Pomax/arduino-midi-recorder/(threads)

Thread 1 (2020-12-24):

pitch bend seems to be encoding the wrong values

Pomax, 2020-12-24:
instead of going from center to top and center to bottom, pitch bending up seems to go from 0 to center, and pitch bending down seems to go from max to center...

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

Pomax, 2020-12-24:
Need to add 0x2000 to the pitch bend value in order to center it correctly.

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

Pomax, 2020-12-24:
fixed

Closed 2020-12-24.

Thread 8 (2021-03-24):

[SOLVED] recorded MIDI files are not useable or corrupt

othmar52, 2021-03-24:
@Pomax thank you for this great project and the detailed documentation!!!
Currently i am trying to build my own recorder with an Arduino UNO R3 and a [TFT/SD shield](https://create.arduino.cc/projecthub/javagoza/2-4-tft-lcd-touch-display-road-test-89f51b) based on your sketch.

Due to the huge amount of PINS used by the shield i have no button for creating markers or any kind of audio debug.
Currently i do not use a RTC as well but i am going to implement this as soon as everything works.

my TFT shows an incoming-note-indicator, incoming cc-indicator, the current filename of the recording and the recording time.
so everything works as expected except one thing:

The created MIDI files seems to be corrupt or not readable.
I tried different kinds of midi file supporting software. One of those is [upload form of onlinesequencer.net](https://onlinesequencer.net/import).

The error message of the "vanilla version" reads:
```
Could not parse MIDI file: Track data exceeds expected length (1/0)
```
After fixing the track_length bytes with `fix.py` i get a different error:
```
Could not parse MIDI file: Track data exceeds expected length (59/56)
```
I also tried to manipulate the calculation of track_length in `fix.py` to avoid the error above but then i get:
```
Unexpected EOF
```

As `.mid`files are not attachable i have created a `.zip` with short recordings of 3 noteOn + noteOff events.
[test-recordings-vanilla-and-fixed.zip](https://github.com/Pomax/arduino-midi-recorder/files/6195740/test-recordings-vanilla-and-fixed.zip)
```
FILE-061-vanilla.MID
FILE-061-fixed_length.MID
```

I used `FAT16` filesystem for the SD.
Obviously there are some bytes in the recordings that shouldn't be there, right?
Do you have any hint how to fix this?

othmar52, 2021-03-24:
i solved it myself:
after formatting the SD card with `FAT32` instead of `FAT16` everything worked

Pomax, 2021-03-25:
Yeah, never use FAT16.

Closed 2021-03-24.

Thread 9 (2021-03-24):

[QUESTION] how to add license in fork?

othmar52, 2021-03-24:
@Pomax As you might have noticed i have created a [fork with a lot of changes](https://github.com/othmar52/arduino-midi-recorder) based on your repository.
I kept your license notice in the main sketch file.
Please tell me if this enough or if a have to do more in terms of license.
I don't want to violate any license agreements!

Pomax, 2021-03-25:
https://github.com/Pomax/arduino-midi-recorder/blob/master/midi-recorder.ino#L379-L388

If you live in a jurisdiction that does not recognize the public domain (France etc), then the code is MIT licensed and you can act in accordance to that - if you live anywhere else, my code is public domain code meaning you're literally free to do whatever you like with it =)

Pomax, 2021-03-25:
That said, I'm not sure how your code works, given that the .mid file hex setup and `writeToFile` function seem to be missing?

othmar52, 2021-03-25:
> meaning you're literally free to do whatever you like with it =)

Thank you for clarification!

> ... it looks like you removed the the .mid file hex setup, as well as the writeToFile function?

No, i only removed the createMarker and the debugAudio stuff. i prefer to have multiple `.ino`'s for better maintainability.
Pretty sure you already know that all existing `.ino`'s gets concatenated during compiling within most ide's!? Case not, maybe you will try it yourself on your next huge sketch.

> ...Now you need a computer...

No, i don't use a computer in my synth setup. but a few standalone midi interfaces with lots of routing options (iConnectivity 1x `mioXL` + 2x `ICM4+`). But you are right, theroretically it is possible to have it inline in my routing but it does not make any sense.
Maybe i'll add a DIN midi in+out too. In my testing of other arduino+midi projects i noticed that USB- and DIN-midi works both without changing anything in the sketch

> ...at the very least, mac and windows...

I dont have those OS. But in general it does not make sense to send midi to an arduino for recording. In such a scenario i would prefer to record the midi directly on the pc.

Pomax, 2021-03-25:
>No, i only removed the createMarker and the debugAudio stuff

I searched your code for writeToFile and don't see it in any of the ino files though?

othmar52, 2021-03-25:
> I searched your code for writeToFile and don't see it in any of the ino files though?

stille there: [20-sd-rtc.ino#L143](https://github.com/othmar52/arduino-midi-recorder/blob/c363afa340de0b1840fa705fc41532facdc41b6e/20-sd-rtc.ino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)

Pomax, 2021-03-25:
oh, interesting that github didn't find it when I used their code search. Then again, their code search has never been all that good...

Closed 2021-08-12.

Thread 10 (2021-08-12):

Add audio?

hendog518, 2021-08-12:
Have you considered a version of this project that also records audio?

I don’t know the first thing about this stuff (if I make this, it’d be my first arduino project) and how much complexity that would add, but for synths and drum machines and other MIDI toys that one might like to use without a pc, I think a parallel recording of the actual audio (and a similar “audio in / audio thru” setup) would add very handy functionality.

Pomax, 2021-08-12:
Given that there are a million fantastic inline audio recorders available at almost every price point: nope. No point, for the cost of an arduino and circuitry, you can get a better assembled, price-appropriate quality consumer device that comes with a manufacturer and shop warranty =)

Closed 2021-08-12.

Thread 11 (2022-07-07):

Playback  & SysEx?

Klokdoc, 2022-07-07:
First of all, what a good idea.  I'm still using a 3 1/2" disc recorder/player which is becoming unreliable.
I'd like to build a similar device that would also play back.   I'd have to record all the SysEx codes as well, my instrument relies on them.  It's a three manual electronic organ with pedals so has four channels, all on one track, and stops, swell pedals, etc are all done by SysEx codes (0F?).  MIDI files produced by this instrument will only work on this instrument, it's a custom design.
Is this feasible?
Thanks,
Chris

ColbyDAllen, 2023-09-20:
How hard would it be to implement a looper with Play/Record functionality that updates an existing SMF format 0 .mid file during playback?

Say you're trying to recorder a drum pattern for instance, so only one channel is needed, and you're just playing a different pitch assigned to a different percussion instrument. Could you write a second line over your first pattern on the same channel, different pitch? Like an audio overdub, but a midi-overdub? Like this:

|| "I'm MIDI file (A)...                                   ...and together we are..." ||
||                          "And I'm MIDI file (B)... ...and together we are..." ||

ONE .MID FILE!!! Lol.

Or maybe simultaneous play record would only be possible if the file being recorded to was not the same one being played?

Just trying to wrap my head around feasibility, whether I'd need a second storage device for playback, or if a fresh overhaul would make more sense.

Best,
Colby

Pomax, 2023-09-20:
That sounds like a MIDI looper, of which there are many already =)

ColbyDAllen, 2023-09-20:
Beautiful! I've tried nearly every other combination of keywords, especially "sequencer" -related projects, but I see you're not kidding. Will be looking into this tomorrow. Thank you.

ColbyDAllen, 2023-10-24:
I was mulling this over this morning, not necesarily SysEx events, but have calls/callbacks outside of the <MIDI.h> looping Note-On events:

Do you think it's possible to have multiple calls to the "void writeToFile(byteType, byte b1, byte b2, int delta)" function?

```
/*
    For instance have the original:
*/
void handleNoteOn(byte channel, byte pitch, byte velocity) {
  writeToFile(NOTE_ON_EVENT, pitch, velocity);
}

/*
    AND have separate function:
*/
void ThisNoteLOOPED(byte channel, byte pitch, byte velocity) {
  writeToFile(NOTE_ON_EVENT, pitch, velocity);
}
```
...working simultaneously...

```
/*
    ...both being fed into the function:
*/
void writeToFile(byte eventType, byte b1, byte b2, int delta) {
  if (!file) return;
  writeVarLen(file, delta);
  file.write(eventType);
  file.write(b1);
  file.write(b2);
}
```

...without breaking how the bytes are being fed to the SD card?

ColbyDAllen, 2023-10-24:
There's a much larger sketch I'm using to toy with this idea, but the above is the distilled concept. Obviously you'd want a corresponding "void ThisNoteOffLOOPED" function for the additional stream of notes...

Happy to share the full sketch if you'd be interested.

Best,
Colby

Pomax, 2023-10-25:
no, what you wrote as "simultaneous" code will write completely different bytes.

(note that I'm closing this issue mostly because we drifted well away from the original issue at this point)

ColbyDAllen, 2023-11-01:
Sorry about that, and got you. Thanks for clarifying!

Pomax, 2023-11-01:
feel free to open a new issue though!

Closed 2023-10-25.

Thread 12 (2023-09-12):

Analog Pins As MIDI-IN?

ColbyDAllen, 2023-09-12:
Hi there!

I built out your project step by step yesterday, and it works great!

However, I'm trying to build a standalone sequencer, equipped with 4 FSR sensors as inputs, outputting midi data over a single midi channel(0). While the 5-PIN DIN works great with your sketch, I'm having trouble with code to replace the input on RX pin 0 with the input from my four analog sensor pins.

I tried replacing all the MIDI.h-related functions/defines/etc. with their usbMIDI.h equivalents (Plus my original sketch for simply reading/ writing the analog signals to 7-bit MIDI messages). Have you tried analog sensors with this project?

Serious thanks for posting your process here, the humor was refreshing, and I'm sure that it has been time consuming.

Best,
Colby ☮️

Pomax, 2023-09-13:
Hmm, can't say I have, but there is the bank of analog pins (A0 through A5) that aren't dedicated RX/TX that you might be able to use for that purpose, too? I used A4 and A5 for the real time clock, but that leaves exactly 4 for individual analog signals =)

ColbyDAllen, 2023-09-13:
Hi Pomax,

Thanks so much for the quick response. Actually I got your sketch to work on a teensy 4.1 with Rev D2 audio shield - but I think after some more reading last night, my problem likely has to do with the file the file management, going from MIDI-->.mid.

Between reading Standard midi specs & what was mentioned here - https://forum.pjrc.com/threads/31797-Teensy-FSR-based-MIDI-controller regarding <usbmidi.h> and <midi h>, it sounds like there may be some inconsistencies between the way the <midi.h> and <usbmidi.h> libraries arrange their information when handing off the bits and bytes to the microSD card.

Probably too much information. Just thought I'd share my experience and (hopeful) implementation of what you've done here.

Everything you shared in your article/project works great so far, thanks again!

Pomax, 2023-09-13:
At least the MIDI spec is stupidly simple, so if you're not afraid of "getting your toes wet" you can have a look at the code in the .ino file that deals with just writing bytes to a file without bothering with any predefined .h file (other than the sd card headers of course =)

ColbyDAllen, 2023-09-18:
Got it working! Thanks ma friend! I took your advice on taking a plunge, or at least dipped a toenail in! Mostly C++ practices (structs, classes, pointers, dereferencing, Namespaces, identifiers, etc...), and routed my analog pins variable[s] through an intermediary function which allowed for the parameters to be rearranged to fit neatly into their respective Status- and data-bytes.

Although I relied on library shortcuts, I'm definitely feeling inspired to study up more on SMF format specifications, 8-to-7-bit bit-shfiting, and the SysEx side of MIDI to reduce reliance on libraries in the future.

Pardon my random jabber.  In case anyone's curious or facing similar challenges, here is the function in Pomax's sketch that required special attention in order to substitute the original 5-pin DIN input with FSR sensors wired to analog pins:

// ======================================================================================
/**
          // delta     eventType       b1        b2
        <delta> <event code> <byte> <byte>
*/
void writeToFile(byte eventType, byte b1, byte b2, int delta) {
  if (!file) return;
  writeVarLen(file, delta);
  file.write(eventType);
  file.write(b1);
  file.write(b2);
}

// ======================================================================================

Phew + Vwalha!! Works as intended so far.

Best,
Colby

Pomax, 2023-09-18:
Nice! (but note that your function comment didn't have the right order for the actual function parameters =D)

ColbyDAllen, 2023-09-18:
My bad😅

Awesome article - hard to overstate. A little C++ fluency has opened my eyes to few open-source projects that incorporate micro-controller-to-SD-Card reading/writing that would’ve been utter Greek to me a week ago.

If you don’t mind me asking, on line 49 of your .ino — What is the purpose of the “HAS_MORE_BYTES 0x80” (note-off, channel 1) global definition? I see it’s used later in the "void writeVarLen(File file, unsigned long value){...}" function provided by the MIDI file format specification, but why the use of a NoteOff message for file writing?

Pomax, 2023-09-20:
it's not "note off, channel 1", it's the bit mask 0x01000000, used to set the the 7th bit to `1` as per the spec requirement for variable length quantities.

> Some numbers in MIDI Files are represented in a form called VARIABLE-LENGTH QUANTITY. These numbers are represented 7 bits per byte, most significant bits first. All bytes except the last have bit 7 set, and the last byte has bit 7 clear. If the number is between 0 and 127, it is thus represented exactly as one byte.

ColbyDAllen, 2023-10-18:
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

Ohh! Got you now. Variable Length Quantity is a bigger deal then I'd realized going into this project. It's starting to make more sense after reading into "bit-masking".  Thank you for the detailed explanation.

Thread 13 (2023-09-15):

SD card lifetime

dazarz, 2023-09-15:
I'm wondering whether the algorithm of such frequent writes to the SD card won't lead to rapid wear and tear of the card. SD cards don't have a long lifespan in terms of write cycles. Perhaps it's better to add a FRAM memory module, collect MIDI events there, and then save them in one go on the SD card. What's your opinion?

Pomax, 2023-09-15:
SD cards have a _huge_ lifespan in terms of write cycles. Modern SD cards will last 10 years or more, and that's if you actually write large data files. This thing writes, at most, kilobytes. Your SD card will easily last a century.

dazarz, 2023-09-16:
Thank you. I hope you are right. I have built the project lately as a start point for my recorder. As a long term Atari Notator user I love the feature of „always midi in record” (even if the record is not enabled) so it will be great to use it not only in Atari world. In my project I will add possibility to stop recording and play the recorded files as well as few more ones if the Arduino’s RAM allows. Thank you for inspiration.

Pomax, 2023-09-17:
Remember that the recorder only writes to file _if there's input_, and even then it only writes data every 400ms. Otherwise it just sits there doing nothing until there's input to record again except for the resetting to a new file every 2 minutes, which is about as low file-writes you can get =)

That said: remember that the midi files aren't "done" when they get closed because their internal checksum will not be set yet. That's what the little `.py` script is for, but you could (if you wanted to invest that time) keep track of the checksum and then update it as part of the file close operation.

dazarz, 2023-09-22:
Checksum... hmm... since the sdcard lifetime is not a problem, so what do you think about such approach:

- Start recording MIDI events to a temporary file (.tmp) on the SD card during the recording.
- Close the temporary file because the recording is complete.
- After recording is finished, calculate the length of the temporary track (number of bytes) and other parameters such as time resolution.
- Open the final MIDI SMF file and write MIDI headers (e.g., format information, number of tracks, time resolution, etc.) in the correct format according to the MIDI SMF file format.
- Reopen the temporary file.
- Read the content of the temporary file and write it to the final file, which already has the correct headers.
- Finally, remove the temporary file (.tmp) because it's no longer needed.

Pomax, 2023-09-22:
This is literally what already happens (the active file _is_ the temporary file in your description), but with steps 5, 6, and 7 done using a Python script that will do this "for all files on the SD card in a single run". We could (almost trivially even) turn the python code into C++ so that when we close a file, we reopen it, compute and write the checksum, before closing it "for real". It would just make the swap from old file to new file take a few ms (at most) longer.

Thread 15 (2025-01-05):

problem of creating empty midi files

Vladistone, 2025-01-05:
I noticed that the function void checkReset() before resetting closes the created file.mid   and thus it is possible to form many empty files from midi data of blanks only from the midi header on 53b.

- [ ] Maybe it is necessary after checking the "empty" period without incoming MIDI traffic need to delete the last created file ... otherwise they multiply and clog the SD card.

- [ ] or have to check the data volume to determine the minimum number of created bytes is not less than (header + track + rhythm) or for reasons of insufficiency of random midi events less than one bar?

```
/**
   Set up a new MIDI file with some boiler plate byte code
*/
void writeMidiPreamble() {
  byte header[] = {
    0x4D, 0x54, 0x68, 0x64,   // "MThd" chunk
    0x00, 0x00, 0x00, 0x06,   // chunk length (from this point on)
    0x00, 0x00,               // format 0
    0x00, 0x01,               // one track
    0x01, 0xD4                // data rate = 458 ticks per quarter note
  };
  file.write(header, 14);

  byte track[] = {
    0x4D, 0x54, 0x72, 0x6B,   // "MTrk" chunk
    0x00, 0x00, 0x00, 0x00    // chunk length placeholder (MSB)
  };
  file.write(track, 8);

  byte tempo[] = {
    0x00,                     // time delta (of zero)
    0xFF, 0x51, 0x03,         // tempo op code
    0x06, 0xFD, 0x1F          // real rate = 458,015μs per quarter note (= 134.681 BPM)
  };
  file.write(tempo, 7);
}
```
function of checkReset:

```
void checkReset() {
  if (startTime == 0) return;
  if (!file) return;
  if (millis() - lastTime > RECORDING_TIMEOUT) {
    if (header & track > 29)
    file.close();
    resetArduino();
  }
}
```

result of IDE monitor:

```
00:46:03.283 -> Initializing SD card... initializaing done
00:46:03.448 ->
00:46:03.448 -> MIDIrec reboot
00:46:03.448 -> A.DBG btn PIN: 2
00:46:03.448 -> MKR btn PIN: 3
00:46:03.448 -> CS PIN: 10

00:46:03.481 -> made: file-001.mid
00:46:03.578 -> made: file-002.mid
00:46:03.675 -> made: file-003.mid
00:46:03.808 -> made: file-004.mid
00:46:03.910 -> made: file-005.mid
00:46:04.008 -> made: file-006.mid
00:46:04.137 -> made: file-007.mid
00:46:04.232 -> made: file-008.mid
00:46:04.331 -> made: file-009.mid
00:46:04.461 -> made: file-010.mid
00:46:04.558 -> made: file-011.mid
00:46:04.689 -> made: file-012.mid
00:46:04.786 -> made: file-013.mid
00:46:04.917 -> made: file-014.mid
00:46:05.015 -> made: file-015.mid
00:46:05.113 -> made: file-016.mid
00:46:05.246 -> made: file-017.mid
00:46:05.345 -> made: file-018.mid
00:46:05.481 -> made: file-019.mid
00:46:05.576 -> made: file-020.mid
00:46:05.706 -> made: file-021.mid
00:46:05.807 -> made: file-022.mid
00:46:05.906 -> made: file-023.mid
00:46:06.038 -> made: file-024.mid
00:46:06.167 -> made: file-025.mid
00:46:06.265 -> made: file-026.mid
00:46:06.396 -> made: file-027.mid
00:46:06.494 -> made: file-028.mid
00:46:06.625 -> open: file-028.mid
```

Pomax, 2025-01-05:
Remember that code blocks need three backticks, not just one (that turns it into inline code, which ends up rendering really wrong =D)

Pomax, 2025-01-05:
added the `starttime` reset in https://github.com/Pomax/arduino-midi-recorder/commit/1581795138eccd51e3043e0a33f0b3c49a8ad483

Vladistone, 2025-01-06:
Thanks for the prompt response. but resetting starttime to zero does not save the code from empty midi files when re-initializing checkReset, as well as with a forced HardReset in the case of removing the SD from the socket (for example, to transfer MIDI to DAW).
I will also note that initializing the SD card deletes the card name created during formatting on a PC, which adds confusion and is a violation of the rules of the game (in other words, if your code does not provide such elementary processing operations with storage media, then it should not delete unauthorized what was done by other flash drive management tools)
```
11:50:38.228 -> Initializing SD card...Initializing done
11:50:38.362 ->
11:50:38.362 -> MIDIrec reboot
11:50:38.362 -> A.DBG btn PIN: 2
11:50:38.362 -> MKR btn PIN: 3
11:50:38.395 -> CS PIN: 10
11:50:38.428 -> made: file-001.mid
11:50:38.529 -> made: file-002.mid
11:50:38.663 -> open: file-002.mid
11:54:18.325 -> Initializing SD card...Initializing done
11:54:18.458 ->
11:54:18.458 -> MIDIrec reboot
11:54:18.492 -> A.DBG btn PIN: 2
11:54:18.492 -> MKR btn PIN: 3
11:54:18.492 -> CS PIN: 10
11:54:18.524 -> made: file-001.mid
11:54:18.624 -> made: file-002.mid
11:54:18.723 -> made: file-003.mid
11:54:18.857 -> open: file-003.mid
```

PS: thanks for code reduction.

Closed 2025-01-05.
