Pomax/arduino-midi-recorder/(commit log)

2020-12-23 pin change
2020-12-24 fixes to MIDI file
    - change TPQN from 4500 to 450
    - ensure that automation data is on channel 1 (0x00)
    - ensure that note data is on channel 13 (0x0C)
    [midi-recorder.ino]
2021-01-17 update circuit diagram
2021-01-18 updated button diagrams
2025-01-05 Update midi-recorder.ino
    Reset `starttime` to the start of file, rather than start of arduino, so that we don't start creating and closing files, but just create a file and then start waiting until it has any content again.
    [midi-recorder.ino]
